sartajChowdhury/PathFinderRobot/Final schematics_.docx

Team 6 Schematics and Validation: Richard Wan, Kevin Zheng, Sam Park, Sartaj Chowdhury

V Diagram


Logic

1. The front and left sensor send data to the arduino
2. Depending on the sensor distance, determine if the two sensors are close or far
3. If the left sensor is far, turn left and move forward a little
4. Left sensor is close and
  a. If front sensor is close, turn right
  b. If front sensor is far, go straight with a bit of right turn biase
5. If the thermophile detects a hot object, set the pwm to 0 for both wheels, send 5V to the buzzer, and delay indefinitely.

Robot and code flow chart:


Truth tables:

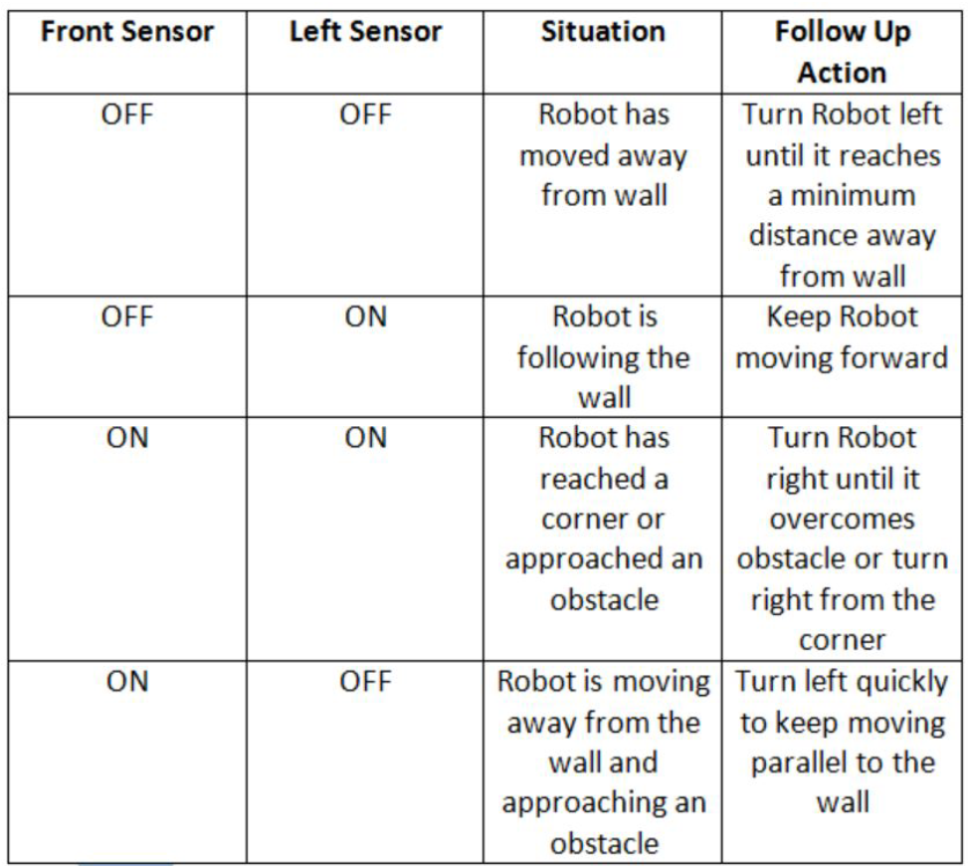
[picture p8: figure]

SF | SL | I1L | I2L | I1R | I2R
0 | 0 | 0 | 0 | 0 | 1
0 | 1 | 1 | 0 | 0 | 1
1 | 0 | 0 | 0 | 0 | 1
1 | 1 | 1 | 0 | 0 | 0

Input Assignments

SF | SL | I1L | I2L | I1R | I2R
0 | 0 | C0 = 0 | 0 | 0 | C0 = 1
0 | 1 | C1 = 1 | 0 | 0 | C1 = 1
1 | 0 | C2 = 0 | 0 | 0 | C2 = 1
1 | 1 | C3 = 1 | 0 | 0 | C3 = 0

There are only four conditions for a left wall following algorithm and there are only 3 behaviors for the robot to exhibit. These include “front/left:far/close” and behaviors “turn left/right” or “go straight”. Using this knowledge we simplified our wiring as the motor driver uses two binary inputs to control wheel rotation. For the 3 behaviors, the wheels will never have to rotate backwards which greatly reduces the complexity of the situation. Thus certain inputs on the motor driver can remain grounded as they will not need any input from the multiplexer. Therefore assigning the multiplexor selection pins to the front and left sensors we can adapt the wall following algorithm truth table to multiplexor and motor driver truth tables. These are shown above. Leaving the permanently grounded ports on the motor driver we assigned the two outputs on the multiplexer to the remaining 2 inputs on the motor driver. The enable pins were permanently grounded as the locomotion termination was done through arduino pwm output as specifically allotted in lecture.

Multiplexer wiring:


Heat Detection Subsystem:

Thermopile Circuit diagram

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
